NadtaphumBadkhunthod/CE_KMITL_Digital_2569_SmartLibrary/(commit log)

2026-10-24 Smart Library: FPGA 2 บอร์ด + ESP8266 เว็บ
    - fpga/board1.vhd: ไฟห้อง แอร์ พัดลม เตือนควัน โต๊ะ, UART กับ ESP8266 และบอร์ด 2
    - fpga/board2.vhd: ไฟโซน 3 ดวง + ไฟชั้น 9 ดวง, 7-segment แสดงตำแหน่ง
    - esp8266/smart_library: เว็บเซิร์ฟเวอร์และหน้าเว็บ (responsive, แจ้งเตือนควันเต็มจอพร้อมเสียง)
    - docs: ตารางขา การต่อสาย และ proposal
2026-10-27 Initial commit: Smart Library FPGA project
    Two EDGE Spartan-7 boards plus the on-board ESP8266 web server.
    - board1.vhd: room light, AC on 7-seg, fan, smoke alarm, binary seat
    count (7 seats), SW18 mode button, melody on Follow
    - board2.vhd: zone and shelf LEDs, location on 7-seg
    - esp_upload.vhd: USB <-> ESP8266 pass-through for flashing
    - smart_library/: ESP8266 sketch and web page
    - fpga_build/: XDC pin files and Vivado build scripts
    - Prebuilt .bit files and upload scripts
    - SYSTEM.md, pins.md, updated proposal (docx/pdf)
2026-10-27 Faster melody on Follow: Super Mario intro
    Replace Twinkle Twinkle (300 ms notes) with the Super Mario Bros.
    opening at 125 ms per note, add rest and G5 notes, shorten the
    inter-note gap to 25 ms. Rebuilt board1_top.bit.
    [board1.vhd]
2026-10-27 Web smoke alarm: switch to Yelp siren
    Replace the 880/660 Hz hi-lo tone with a fast 700->1500 Hz sawtooth
    sweep, 4 sweeps per second. Add alarm_sounds_preview.html for
    auditioning the alarm options.
2026-10-27 LCD shows fire alarm message during smoke danger
    Line 1 shows "!! FIRE ALARM !!", line 2 blinks "EVACUATE NOW" in time
    with the buzzer. Seat counts return as soon as the smoke clears.
    Rebuilt board1_top.bit.
    [board1.vhd, smart_library.ino]
2026-10-27 Proposal and docs: library computer, 3 room LEDs on one pin, 220 ohm
    - Users search on a library computer already joined to the ESP8266
    Wi-Fi, not on their own devices
    - Room light is 3 white LEDs in parallel on one output pin (M13)
    - LED resistors are 220 ohm (15 total); drop jumper wires from list
    - Redraw diagram, rebuild proposal docx/pdf
    - Add proposal_src/ with the generator scripts and diagram
2026-10-27 Add Design Document (Top-Down design, research, development, testing)
    - DesignDocument_SmartLibrary.docx/pdf, 24 pages
    - Figures: top-down hierarchy, board1/board2 block diagrams, FSMs
    - Vivado utilization and timing figures for both boards
    - design_doc_src/ with the generator script and figure sources
2026-10-27 Design doc: restyle tables, chapter titles, running header
    - Light gray table borders, cell padding, centred header row, vertical centring
    - Chapter titles 22pt centred; section spacing tightened
    - Running header with document title; smaller spacer after tables/code
    - Replace ohm sign (missing in TH Sarabun New) with Thai word
2026-10-27 Design doc: format after the official proposal sample
    - Compact bold headings (18/16pt), dash bullets, continuous flow
    - Thin black table lines, 15pt table text, tables flow across pages
    with repeated header row
    - Keep TH Sarabun New (SarabunIT9 renders Arabic digits as Thai digits)
2026-10-27 Design doc: follow the sample Design Document layout
    - Cover with KMITL seal, 'จัดทำโดย' and 'วิชา' blocks
    - Chapters as in the sample: บทนำ, ทฤษฎี, อุปกรณ์และเครื่องมือ,
    การออกแบบและการพัฒนา, โค้ด VHDL, ผลการทดลอง, สรุป, แหล่งจัดเก็บข้อมูล
    - Centered chapter titles on new pages, 'ภาพที่' captions
    - Redrawn figures at 1000px width so text stays readable when printed
    - Table identifiers at body size, results column is a checkbox only
2026-10-29 Update all docs to current system
    - SYSTEM.md: LCD fire message and Yelp siren in smoke system and tests,
    file list now covers proposal, design doc, source folders, alarm preview
    - Proposal: LCD fire alarm message and web siren; work plan table kept
    on one page; rebuilt docx/pdf
    - Design Document: Word file replaced with the latest build
    - design_doc_src/README: current figure names and seal image
2026-10-29 Add README; add edited Design Document v2
    - README.md updated from the Oct 24 GitHub version to the current
    system (7 seats, mode button, melody, LCD fire alarm, 3 room LEDs)
    - DesignDocument_SmartLibrary_v2.docx: user-edited Word version
2026-10-29 Reorganize into fpga/ and esp8266/; keep notes and test files local
    - fpga/board1, fpga/board2, fpga/esp_upload: VHDL, bit, xdc, build tcl, PROM upload script
    - esp8266/smart_library: ESP8266 sketch and web page
    - SYSTEM.md, pins.md, web.html, alarm preview moved to ignored _local/
    - SRAM (test) upload scripts ignored
    - build tcl read_vhdl paths updated
2026-10-30 Reformat ESP8266 sketch with Arduino formatter; drop song comment in board1
